covah901/CN62B---Ergo-Keyboard/qmk firmware/mysterium62b.jpg

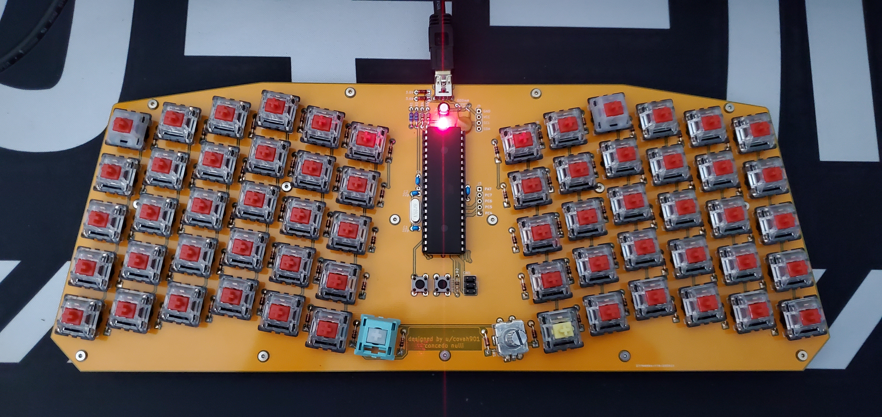
qmk firmware/mysterium62b.jpg
