covah901/CN62B---Ergo-Keyboard/README.md

# CN62B - Ergo Keyboard 
AtMega32A Ergo keyboard based on CFTKB's Mysterium
https://imgur.com/a/Je4tYqu
