covah901/CN62B---Ergo-Keyboard/qmk firmware/readme.md

# BASED ON MYSTERIUM

Sorry I didn't come up with a better name. This is mostly an abanonded prototype. 

An Ergo keyboard that can be assembled with only through hole components, heavily based on Mysterium. 

* Mysterium Keyboard Maintainer: [coseyfannitutti](https://github.com/coseyfannitutti)

Make and flash example for this keyboard (after setting up your build environment):

    make mysterium62b:default:flash

See the [build environment setup](https://docs.qmk.fm/#/getting_started_build_tools) and the [make instructions](https://docs.qmk.fm/#/getting_started_make_guide) for more information. Brand new to QMK? Start with our [Complete Newbs Guide](https://docs.qmk.fm/#/newbs).

[List of Parts](https://octopart.com/bom-tool/wr8C8imk)
