covah901/CN62B---Ergo-Keyboard/atmega32A_ergo.kicad_pcb

## KiCad design atmega32A_ergo.kicad_pcb (2020-06-23)

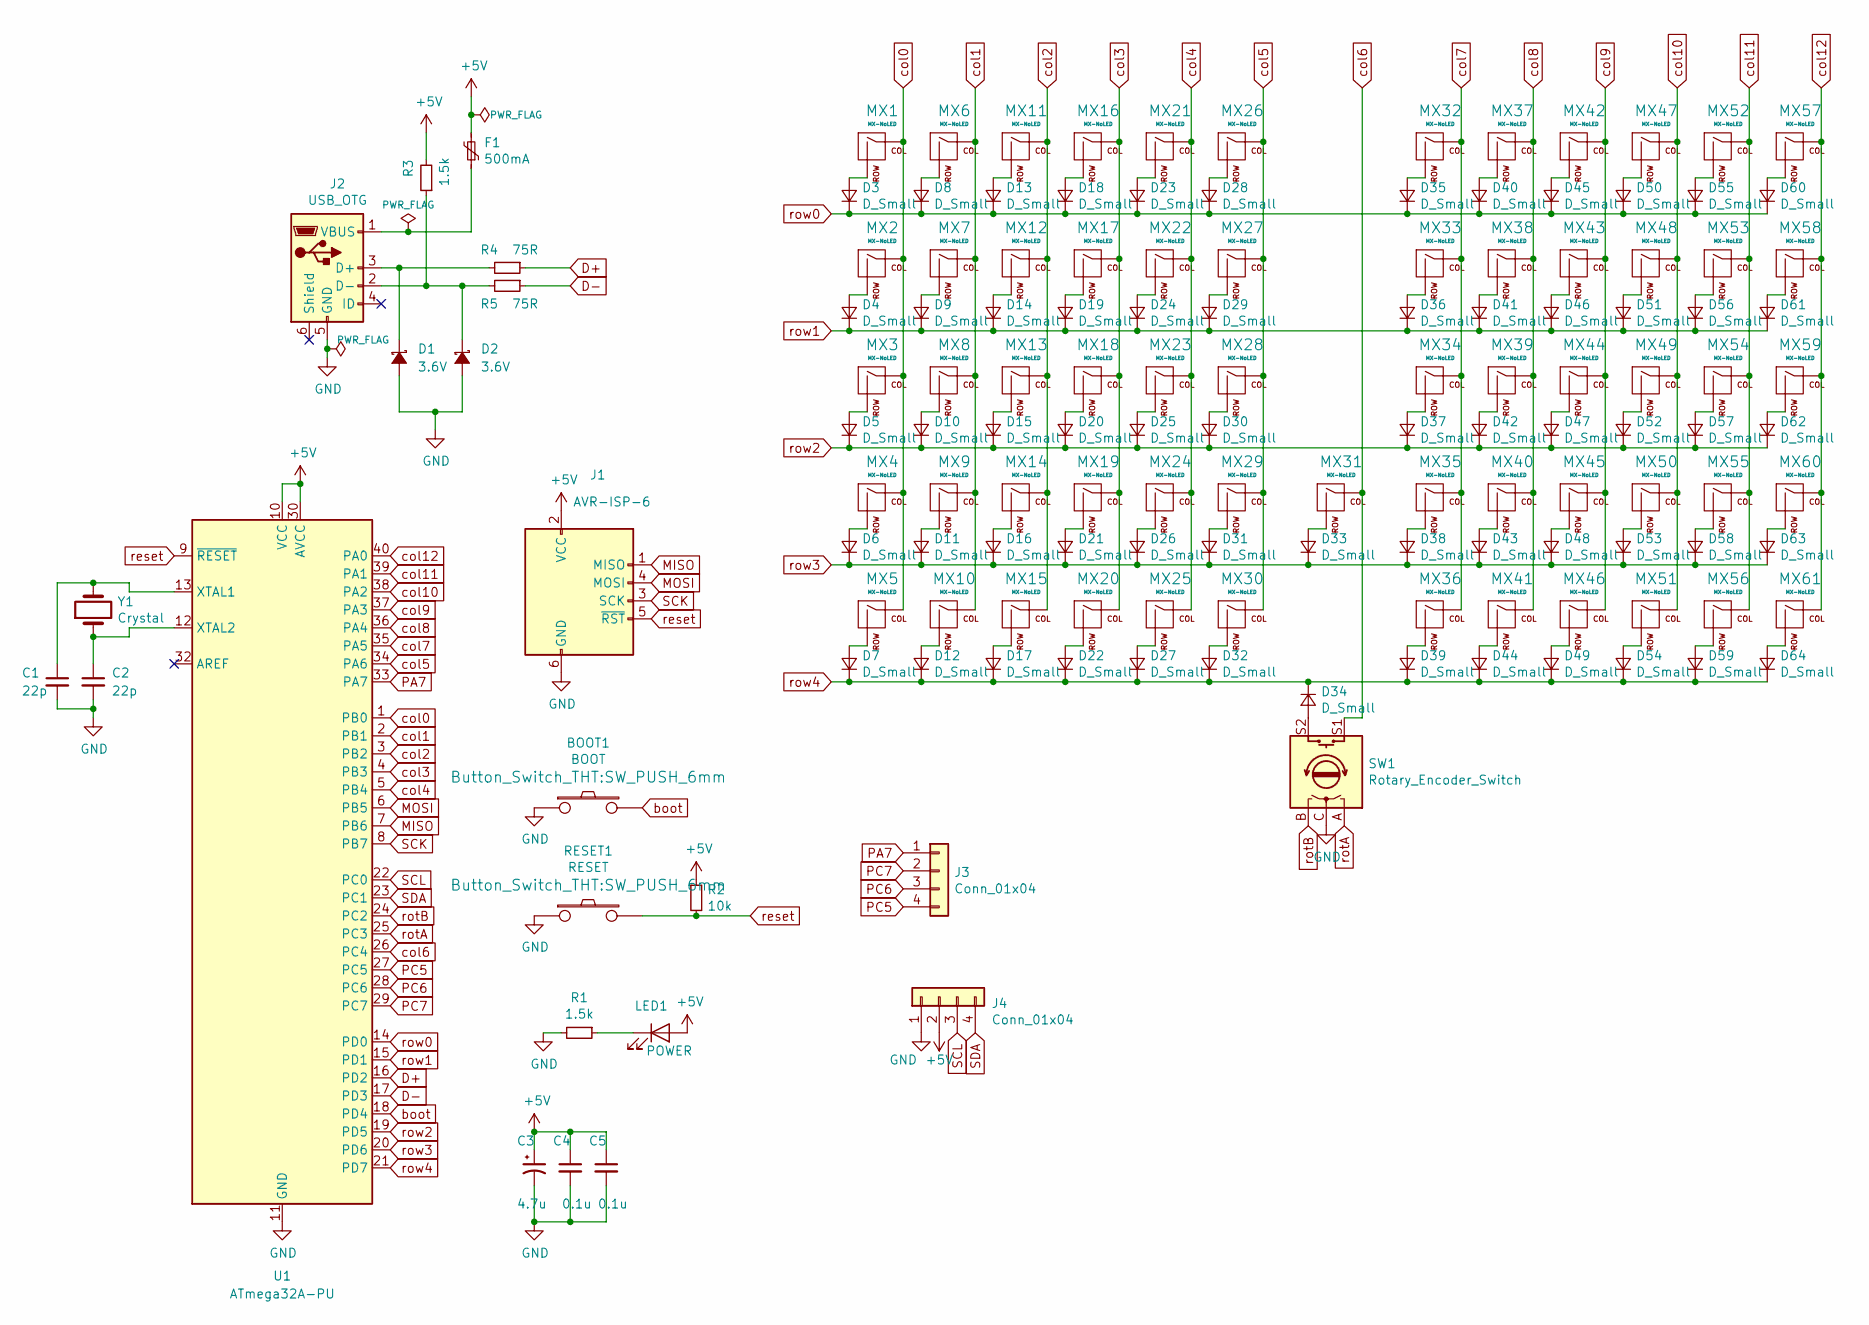
[picture p2: schematic atmega32A_ergo.sch]

Parts:
BOOT1: BOOT; SW_PUSH_6mm
C1, C2: 22p; C_Disc_D3.0mm_W1.6mm_P2.50mm
C3: 4.7u; CP_Radial_D4.0mm_P1.50mm
C4, C5: 0.1u; C_Disc_D4.3mm_W1.9mm_P5.00mm
D1, D2: 3.6V; D_DO-35_SOD27_P5.08mm_Vertical_AnodeUp
D3, D4, D5, D6, D7, D8, D9, D10, D11, D12, D13, D14, D15, D16, D17, D18, D19, D20, D21, D22, D23, D24, D25, D26, D27, D28, D29, D30, D31, D32, D33, D34, D35, D36, D37, D38, D39, D40, D41, D42, D43, D44, D45, D46, D47, D48, D49, D50, D51, D52, D53, D54, D55, D56, D57, D58, D59, D60, D61, D62, D63, D64: D_Small; Diode_Long
F1: 500mA; polyfuse_5.1mm
J1: AVR-ISP-6; AVR_ICSP_3x2
J2: USB_OTG; USB-Mini-B_ LCSC-C46398
J3, J4: Conn_01x04; PinHeader_1x04_P2.54mm_Vertical
LED1: POWER; LED_D3.0mm
MX1, MX2, MX3, MX4, MX5, MX6, MX7, MX8, MX9, MX10, MX11, MX12, MX13, MX14, MX15, MX16, MX17, MX18, MX19, MX20, MX21, MX22, MX23, MX24, MX25, MX26, MX27, MX28, MX29, MX30, MX31, MX32, MX33, MX34, MX35, MX36, MX37, MX38, MX39, MX40, MX41, MX42, MX43, MX44, MX45, MX46, MX47, MX48, MX49, MX50, MX51, MX52, MX53, MX54, MX55, MX56, MX57, MX58, MX59, MX60, MX61: MX-NoLED; MX_PCB_100H
R1, R3: 1.5k; R_Axial_DIN0204_L3.6mm_D1.6mm_P7.62mm_Horizontal
R2: 10k; R_Axial_DIN0204_L3.6mm_D1.6mm_P7.62mm_Horizontal
R4, R5: 75R; R_Axial_DIN0204_L3.6mm_D1.6mm_P7.62mm_Horizontal
RESET1: RESET; SW_PUSH_6mm
SW1: Rotary_Encoder_Switch; RotaryEncoder_Alps_EC11E-Switch_Vertical_H20mm
U1: ATmega32A-PU; DIP-40_W15.24mm
Y1: Crystal; Crystal_HC49-4H_Vertical

Connections:
+5V: C3.1, C4.1, C5.1, F1.2, J1.2 (VCC), J4.2, LED1.2 (A), R2.1, R3.2, U1.10 (VCC), U1.30 (AVCC); also elsewhere on the board
D+: R4.1, U1.16 (PD2)
D-: R5.1, U1.17 (PD3)
GND: BOOT1.1, C1.2, C2.2, C3.2, C4.2, C5.2, D1.2 (A), D2.2 (A), J1.6 (GND), J2.5 (GND), J4.1, R1.2, RESET1.1, SW1.C, U1.11 (GND), U1.31 (GND); also elsewhere on the board
MISO: J1.1 (MISO), U1.7 (PB6)
MOSI: J1.4 (MOSI), U1.6 (PB5)
unnamed: C1.1, U1.13 (XTAL1), Y1.2
unnamed: C2.1, U1.12 (XTAL2), Y1.1
unnamed: D1.1 (K), J2.3 (D+), R4.2
unnamed: D2.1 (K), J2.2 (D-), R3.1, R5.2
unnamed: D3.2 (A), MX1.2 (ROW)
unnamed: D4.2 (A), MX2.2 (ROW)
unnamed: D5.2 (A), MX3.2 (ROW)
unnamed: D6.2 (A), MX4.2 (ROW)
unnamed: D7.2 (A), MX5.2 (ROW)
unnamed: D8.2 (A), MX6.2 (ROW)
unnamed: D9.2 (A), MX7.2 (ROW)
unnamed: D10.2 (A), MX8.2 (ROW)
unnamed: D11.2 (A), MX9.2 (ROW)
unnamed: D12.2 (A), MX10.2 (ROW)
unnamed: D13.2 (A), MX11.2 (ROW)
unnamed: D14.2 (A), MX12.2 (ROW)
unnamed: D15.2 (A), MX13.2 (ROW)
unnamed: D16.2 (A), MX14.2 (ROW)
unnamed: D17.2 (A), MX15.2 (ROW)
unnamed: D18.2 (A), MX16.2 (ROW)
unnamed: D19.2 (A), MX17.2 (ROW)
unnamed: D20.2 (A), MX18.2 (ROW)
unnamed: D21.2 (A), MX19.2 (ROW)
unnamed: D22.2 (A), MX20.2 (ROW)
unnamed: D23.2 (A), MX21.2 (ROW)
unnamed: D24.2 (A), MX22.2 (ROW)
unnamed: D25.2 (A), MX23.2 (ROW)
unnamed: D26.2 (A), MX24.2 (ROW)
unnamed: D27.2 (A), MX25.2 (ROW)
unnamed: D28.2 (A), MX26.2 (ROW)
unnamed: D29.2 (A), MX27.2 (ROW)
unnamed: D30.2 (A), MX28.2 (ROW)
unnamed: D31.2 (A), MX29.2 (ROW)
unnamed: D32.2 (A), MX30.2 (ROW)
unnamed: D33.2 (A), MX31.2 (ROW)
unnamed: D34.2 (A), SW1.S2
unnamed: D35.2 (A), MX32.2 (ROW)
unnamed: D36.2 (A), MX33.2 (ROW)
unnamed: D37.2 (A), MX34.2 (ROW)
unnamed: D38.2 (A), MX35.2 (ROW)
unnamed: D39.2 (A), MX36.2 (ROW)
unnamed: D40.2 (A), MX37.2 (ROW)
unnamed: D41.2 (A), MX38.2 (ROW)
unnamed: D42.2 (A), MX39.2 (ROW)
unnamed: D43.2 (A), MX40.2 (ROW)
unnamed: D44.2 (A), MX41.2 (ROW)
unnamed: D45.2 (A), MX42.2 (ROW)
unnamed: D46.2 (A), MX43.2 (ROW)
unnamed: D47.2 (A), MX44.2 (ROW)
unnamed: D48.2 (A), MX45.2 (ROW)
unnamed: D49.2 (A), MX46.2 (ROW)
unnamed: D50.2 (A), MX47.2 (ROW)
unnamed: D51.2 (A), MX48.2 (ROW)
unnamed: D52.2 (A), MX49.2 (ROW)
unnamed: D53.2 (A), MX50.2 (ROW)
unnamed: D54.2 (A), MX51.2 (ROW)
unnamed: D55.2 (A), MX52.2 (ROW)
unnamed: D56.2 (A), MX53.2 (ROW)
unnamed: D57.2 (A), MX54.2 (ROW)
unnamed: D58.2 (A), MX55.2 (ROW)
unnamed: D59.2 (A), MX56.2 (ROW)
unnamed: D60.2 (A), MX57.2 (ROW)
unnamed: D61.2 (A), MX58.2 (ROW)
unnamed: D62.2 (A), MX59.2 (ROW)
unnamed: D63.2 (A), MX60.2 (ROW)
unnamed: D64.2 (A), MX61.2 (ROW)
unnamed: F1.1, J2.1 (VBUS)
unnamed: LED1.1 (K), R1.1
PA7: J3.1, U1.33 (PA7)
PC5: J3.4, U1.27 (PC5)
PC6: J3.3, U1.28 (PC6)
PC7: J3.2, U1.29 (PC7)
SCK: J1.3 (SCK), U1.8 (PB7)
SCL: J4.3, U1.22 (PC0); also elsewhere on the board
SDA: J4.4, U1.23 (PC1); also elsewhere on the board
boot: BOOT1.2, U1.18 (PD4)
col0: MX1.1 (COL), MX2.1 (COL), MX3.1 (COL), MX4.1 (COL), MX5.1 (COL), U1.1 (PB0)
col1: MX6.1 (COL), MX7.1 (COL), MX8.1 (COL), MX9.1 (COL), MX10.1 (COL), U1.2 (PB1)
col2: MX11.1 (COL), MX12.1 (COL), MX13.1 (COL), MX14.1 (COL), MX15.1 (COL), U1.3 (PB2)
col3: MX16.1 (COL), MX17.1 (COL), MX18.1 (COL), MX19.1 (COL), MX20.1 (COL), U1.4 (PB3)
col4: MX21.1 (COL), MX22.1 (COL), MX23.1 (COL), MX24.1 (COL), MX25.1 (COL), U1.5 (PB4)
col5: MX26.1 (COL), MX27.1 (COL), MX28.1 (COL), MX29.1 (COL), MX30.1 (COL), U1.34 (PA6)
col6: MX31.1 (COL), SW1.S1, U1.26 (PC4)
col7: MX32.1 (COL), MX33.1 (COL), MX34.1 (COL), MX35.1 (COL), MX36.1 (COL), U1.35 (PA5)
col8: MX37.1 (COL), MX38.1 (COL), MX39.1 (COL), MX40.1 (COL), MX41.1 (COL), U1.36 (PA4)
col9: MX42.1 (COL), MX43.1 (COL), MX44.1 (COL), MX45.1 (COL), MX46.1 (COL), U1.37 (PA3)
col10: MX47.1 (COL), MX48.1 (COL), MX49.1 (COL), MX50.1 (COL), MX51.1 (COL), U1.38 (PA2)
col11: MX52.1 (COL), MX53.1 (COL), MX54.1 (COL), MX55.1 (COL), MX56.1 (COL), U1.39 (PA1)
col12: MX57.1 (COL), MX58.1 (COL), MX59.1 (COL), MX60.1 (COL), MX61.1 (COL), U1.40 (PA0)
reset: J1.5 (~RST), R2.2, RESET1.2, U1.9 (~RESET)
rotA: SW1.A, U1.25 (PC3)
rotB: SW1.B, U1.24 (PC2)
row0: D3.1 (K), D8.1 (K), D13.1 (K), D18.1 (K), D23.1 (K), D28.1 (K), D35.1 (K), D40.1 (K), D45.1 (K), D50.1 (K), D55.1 (K), D60.1 (K), U1.14 (PD0)
row1: D4.1 (K), D9.1 (K), D14.1 (K), D19.1 (K), D24.1 (K), D29.1 (K), D36.1 (K), D41.1 (K), D46.1 (K), D51.1 (K), D56.1 (K), D61.1 (K), U1.15 (PD1)
row2: D5.1 (K), D10.1 (K), D15.1 (K), D20.1 (K), D25.1 (K), D30.1 (K), D37.1 (K), D42.1 (K), D47.1 (K), D52.1 (K), D57.1 (K), D62.1 (K), U1.19 (PD5)
row3: D6.1 (K), D11.1 (K), D16.1 (K), D21.1 (K), D26.1 (K), D31.1 (K), D33.1 (K), D38.1 (K), D43.1 (K), D48.1 (K), D53.1 (K), D58.1 (K), D63.1 (K), U1.20 (PD6)
row4: D7.1 (K), D12.1 (K), D17.1 (K), D22.1 (K), D27.1 (K), D32.1 (K), D34.1 (K), D39.1 (K), D44.1 (K), D49.1 (K), D54.1 (K), D59.1 (K), D64.1 (K), U1.21 (PD7)

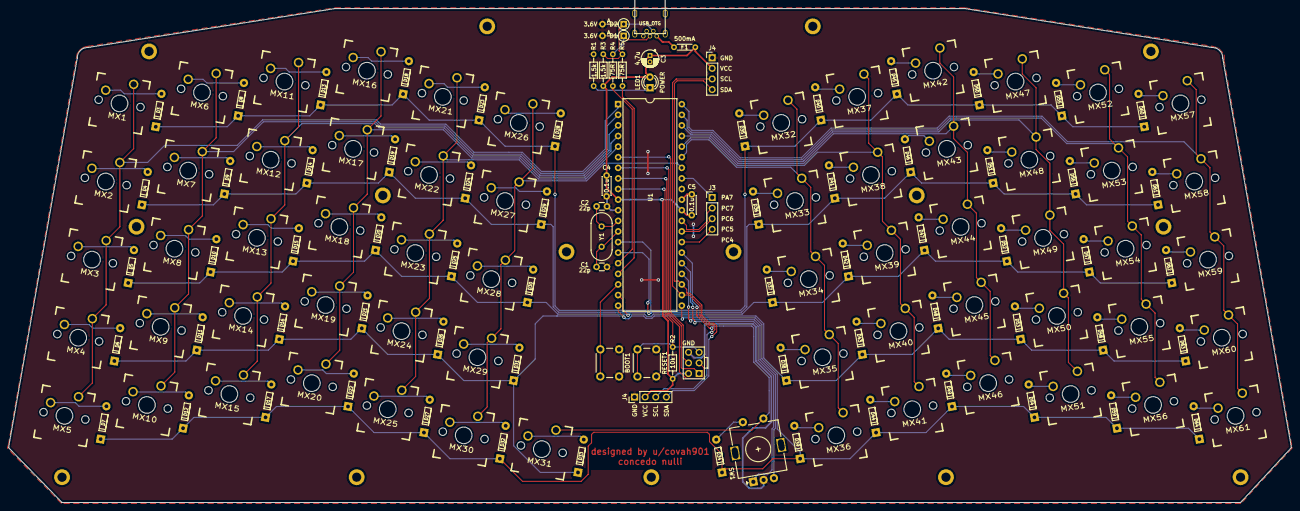
[picture p3: board atmega32A_ergo.kicad_pcb from above]

Board: 2 copper layers, 307.3 x 118.3 mm, 147 parts (0 on the bottom side), 103 nets.

Other parts of the board:
J4#2: Conn_01x04; PinHeader_1x04_P2.54mm_Vertical

Their connections:
+5V: J4#2.2; also elsewhere on the board
GND: J4#2.1; also elsewhere on the board
SCL: J4#2.3; also elsewhere on the board
SDA: J4#2.4; also elsewhere on the board
